vezril/EtherCoffee/flowcharts/eth0 init diagram.png

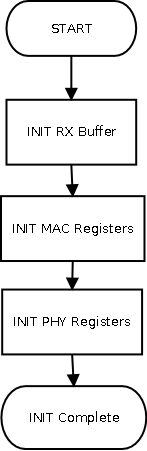
flowcharts/eth0 init diagram.png
