vezril/EtherCoffee/flowcharts/Exports/8088 - Init.png

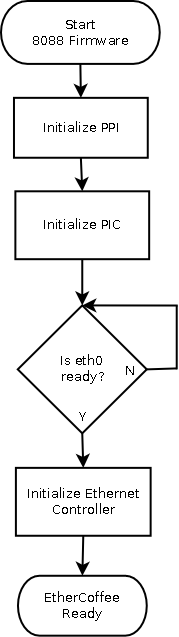
flowcharts/Exports/8088 - Init.png
