vezril/EtherCoffee/flowcharts/Exports/8088 - Poll.png

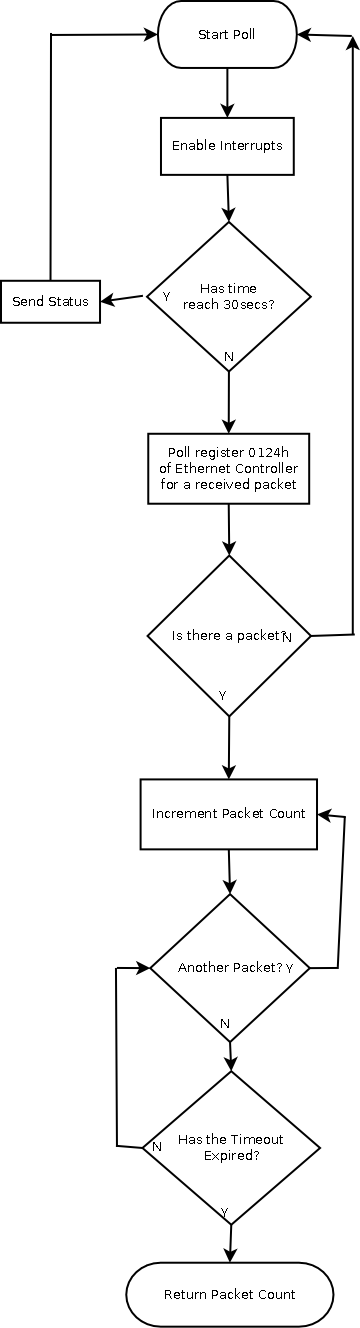
flowcharts/Exports/8088 - Poll.png
