vezril/EtherCoffee/flowcharts/Exports/8088 - Process Packets.png

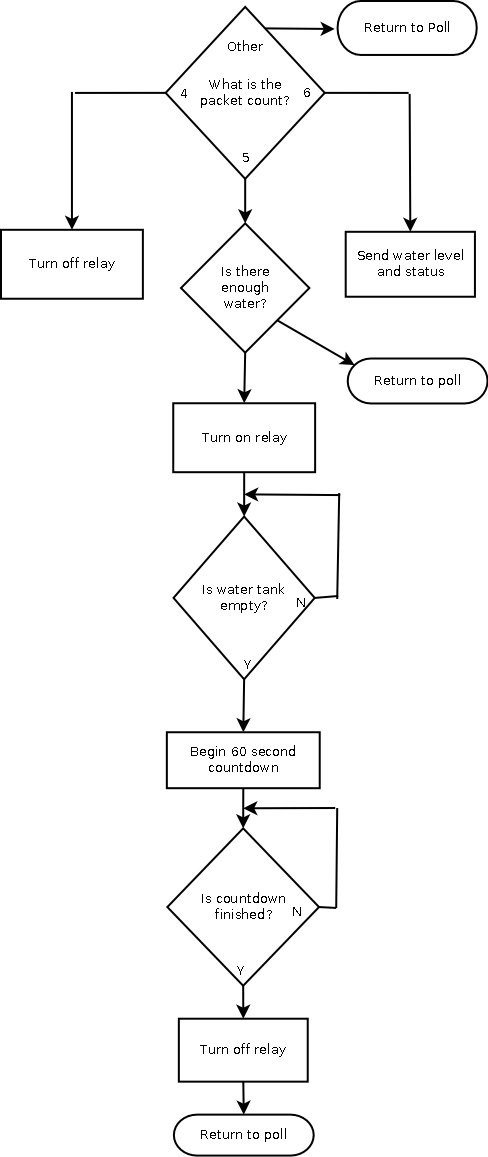
flowcharts/Exports/8088 - Process Packets.png
