vezril/EtherCoffee/flowcharts/Exports/8088 - recv.png

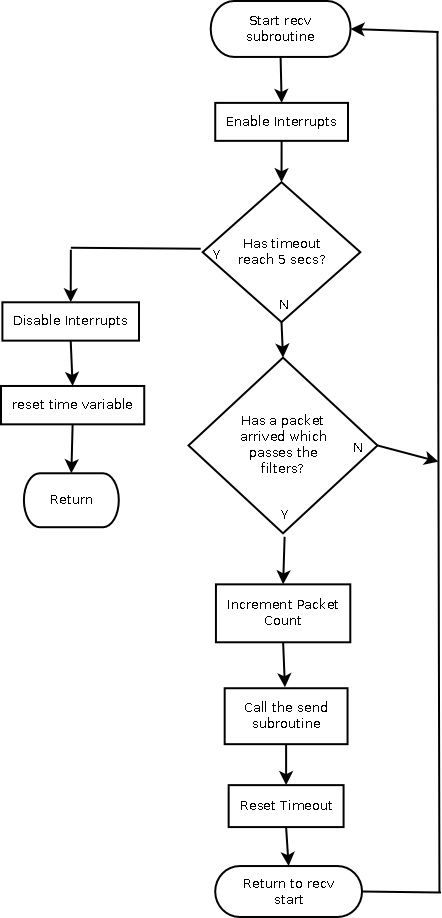
flowcharts/Exports/8088 - recv.png
