vezril/EtherCoffee/flowcharts/Exports/8088 - RTC.png

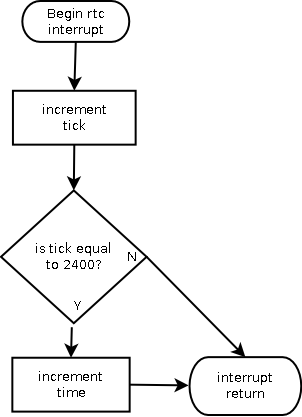
flowcharts/Exports/8088 - RTC.png
