vezril/EtherCoffee/flowcharts/Exports/ethercoffee - main.png

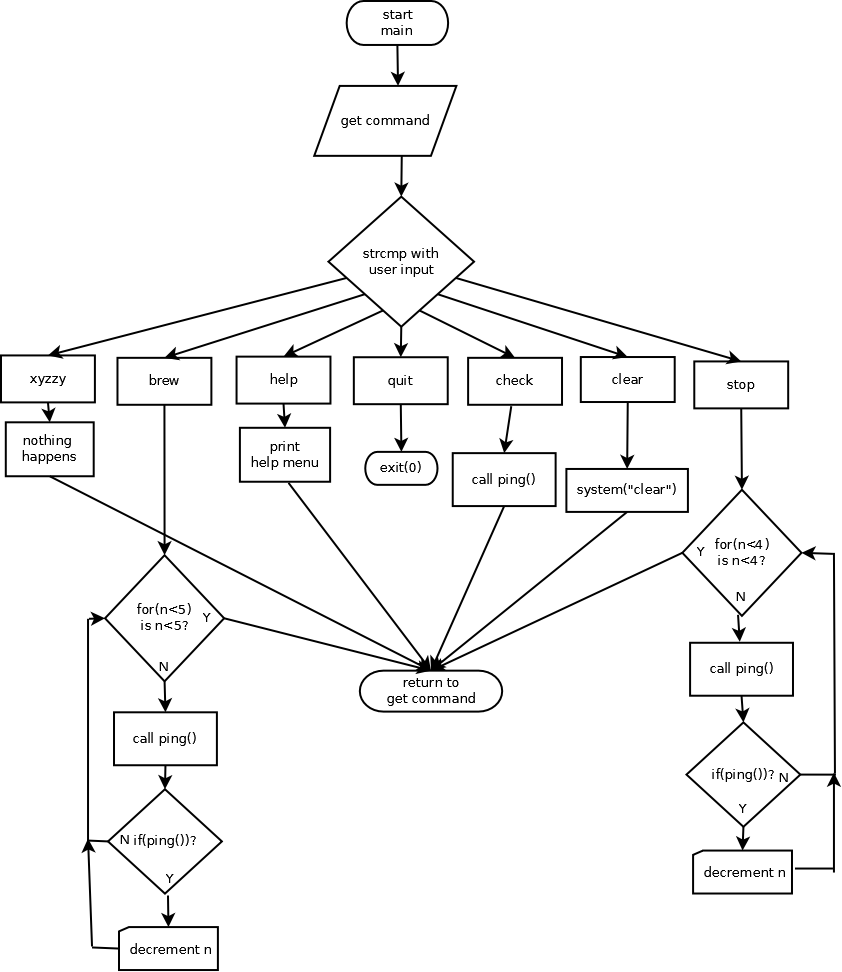
flowcharts/Exports/ethercoffee - main.png
