vezril/EtherCoffee/flowcharts/Exports/ethercoffee - ping.png

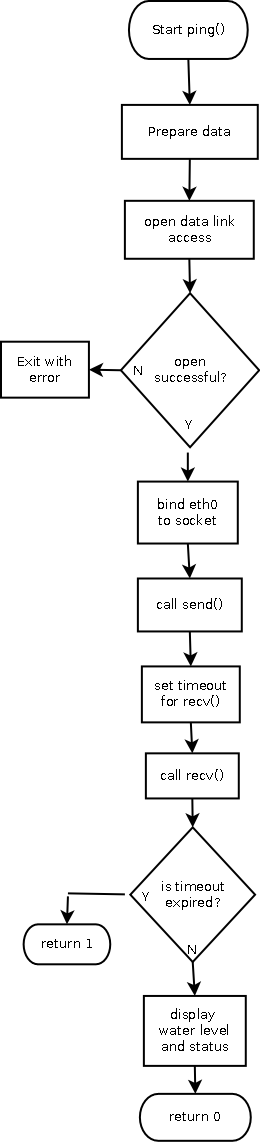
flowcharts/Exports/ethercoffee - ping.png
