vezril/EtherCoffee/flowcharts/Exports/ethercoffee - send.png

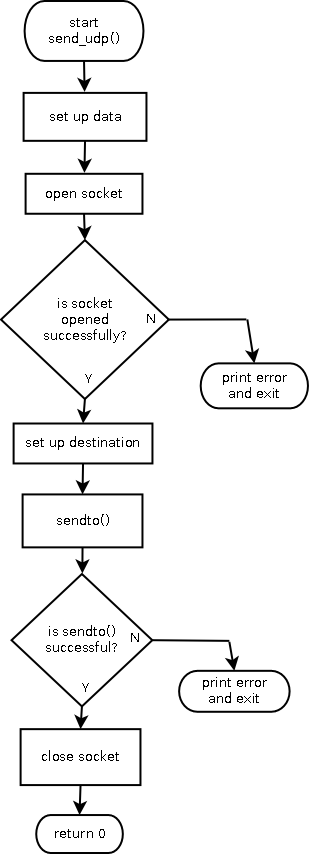
flowcharts/Exports/ethercoffee - send.png
