vezril/EtherCoffee/flowcharts/Exports/GUI - Brew.png

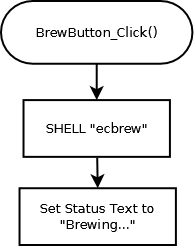
flowcharts/Exports/GUI - Brew.png
