vezril/EtherCoffee/flowcharts/Exports/GUI - Form_Open.png

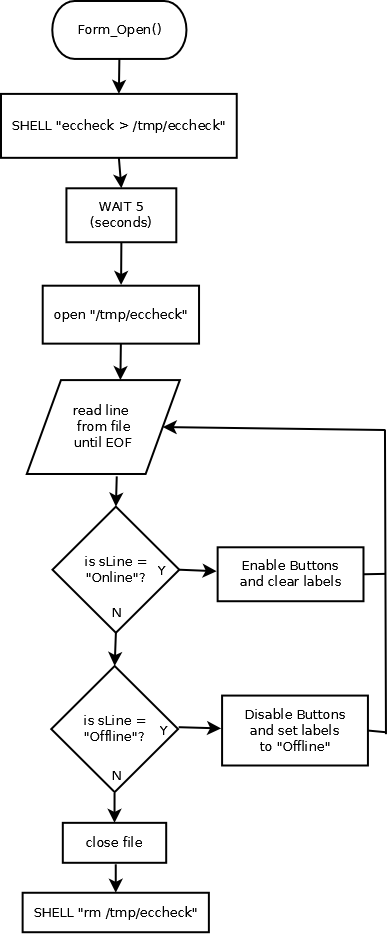
flowcharts/Exports/GUI - Form_Open.png
