vezril/EtherCoffee/flowcharts/Exports/GUI - Status.png

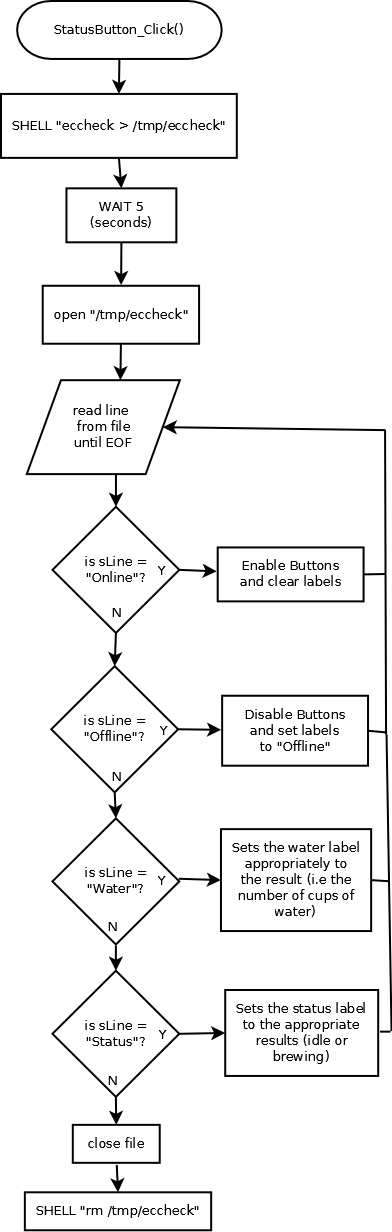
flowcharts/Exports/GUI - Status.png
