vezril/EtherCoffee/pcb/Switch/pcb_layout.jpg

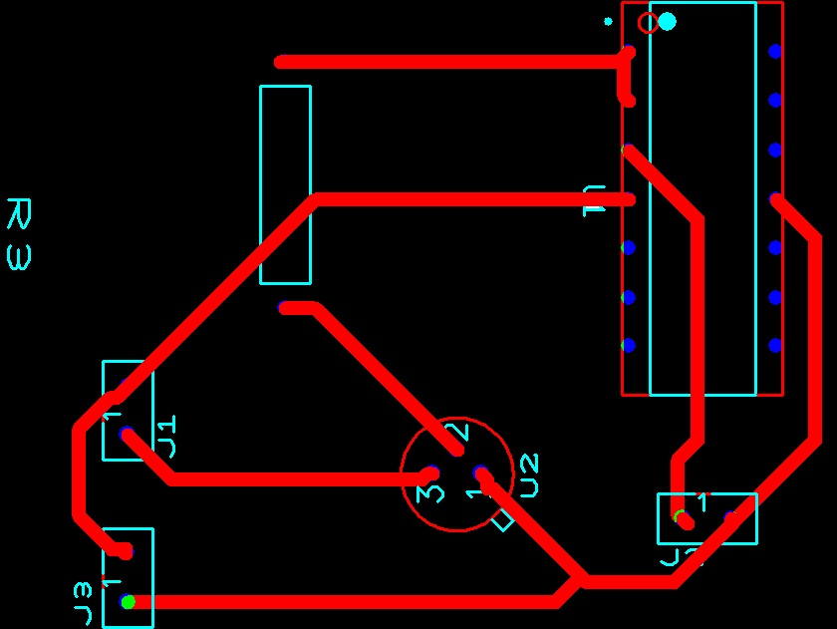
pcb/Switch/pcb_layout.jpg
