vezril/EtherCoffee/pictures/brew.png

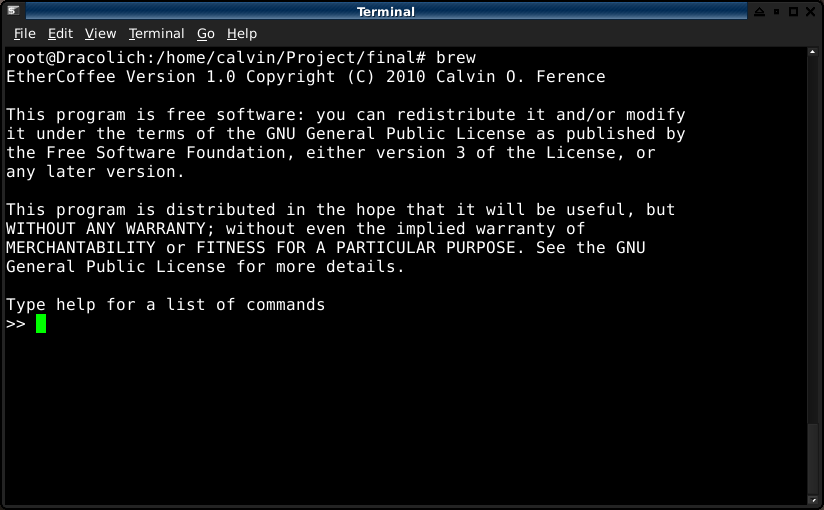
pictures/brew.png
