vezril/EtherCoffee/pictures/Cali - 1.jpg

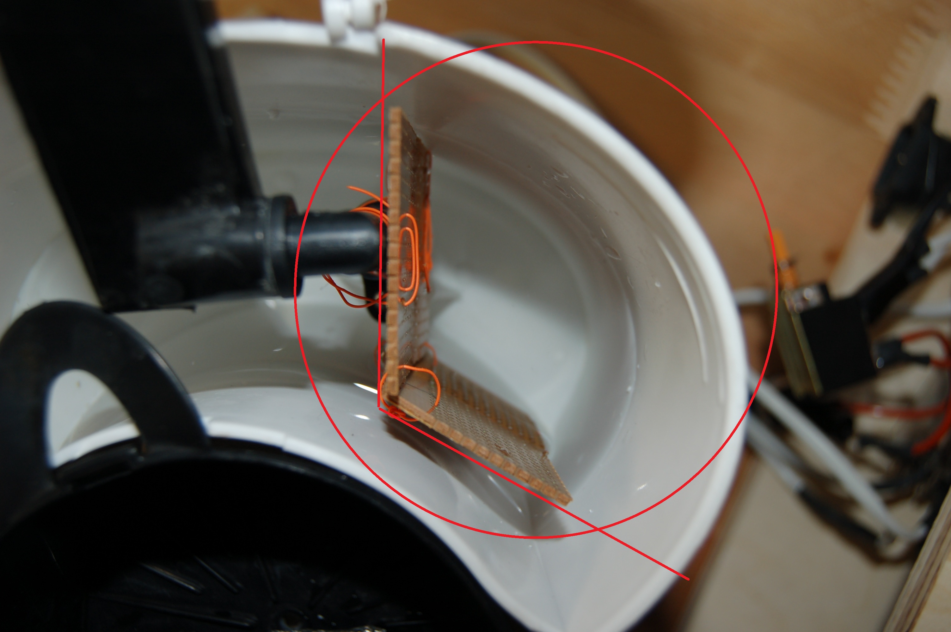
pictures/Cali - 1.jpg
