vezril/EtherCoffee/pictures/Cali - 2.jpg

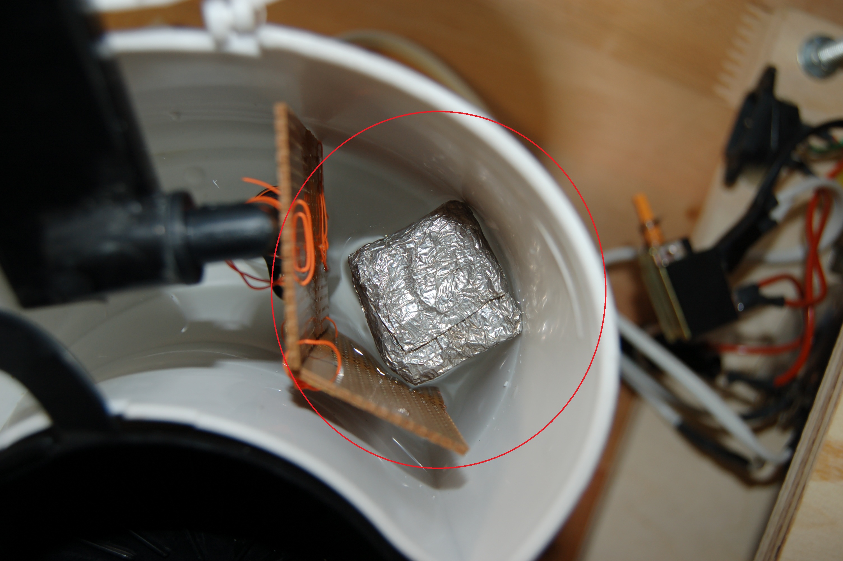
pictures/Cali - 2.jpg
