vezril/EtherCoffee/pictures/cartoon_fire.gif

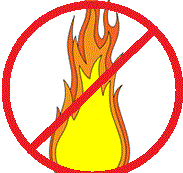
pictures/cartoon_fire.gif
