vezril/EtherCoffee/pictures/DigiCam/DSC_0043.JPG

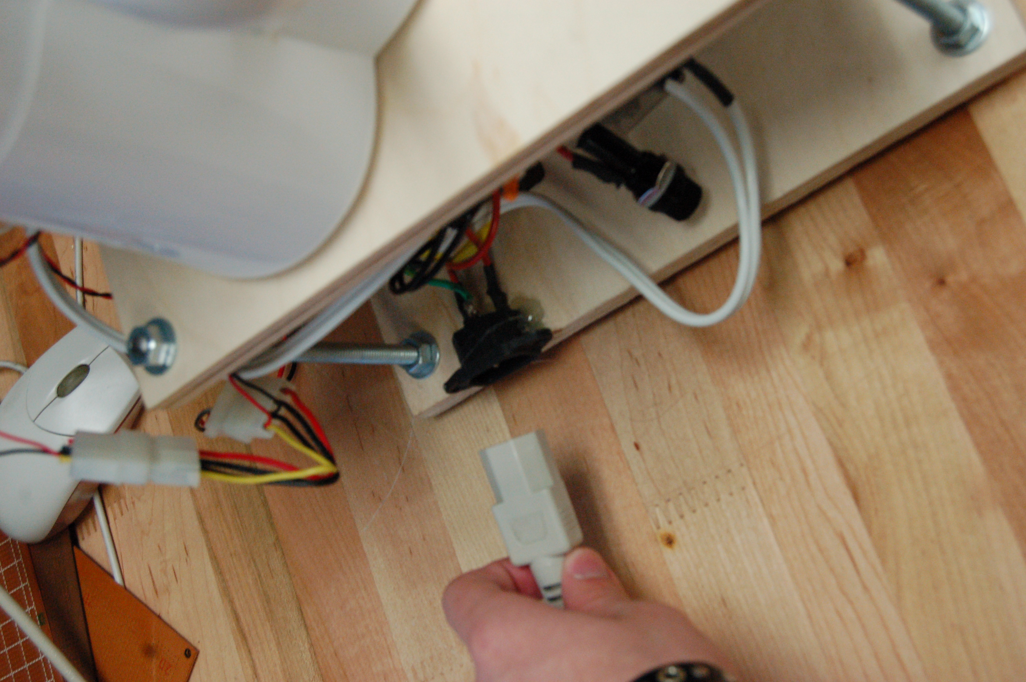
pictures/DigiCam/DSC_0043.JPG
