vezril/EtherCoffee/pictures/DigiCam/DSC_0044.JPG

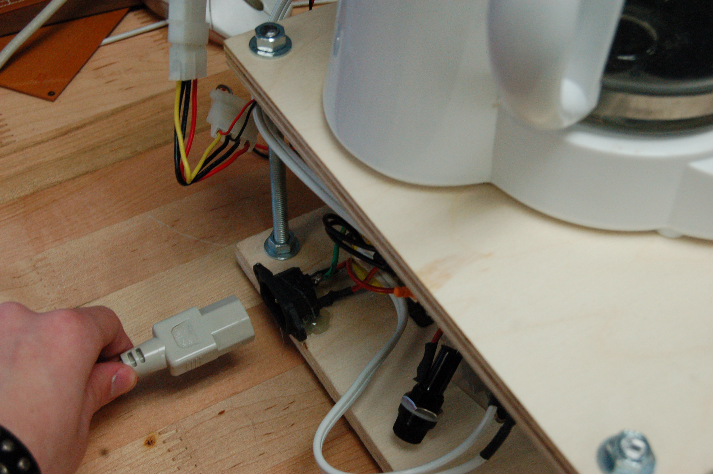
pictures/DigiCam/DSC_0044.JPG
