vezril/EtherCoffee/pictures/DigiCam/DSC_0045.JPG

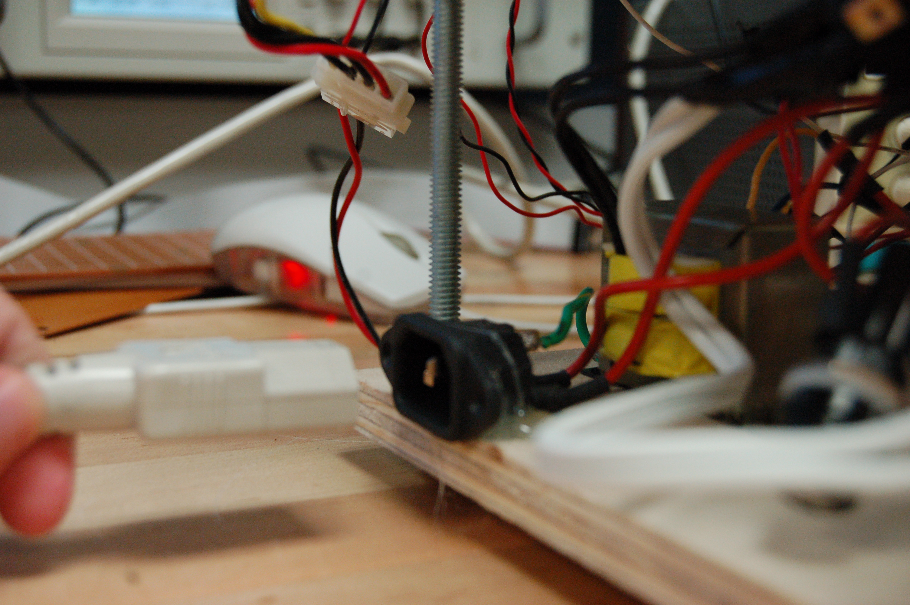
pictures/DigiCam/DSC_0045.JPG
