vezril/EtherCoffee/pictures/DigiCam/DSC_0047.JPG

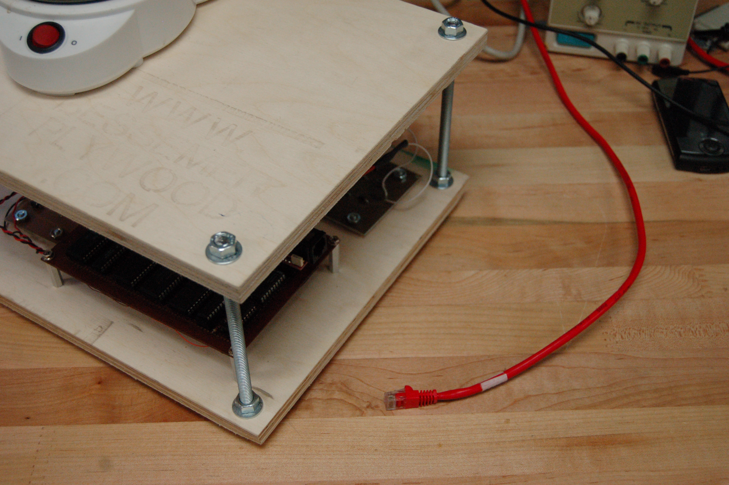
pictures/DigiCam/DSC_0047.JPG
