vezril/EtherCoffee/pictures/DigiCam/DSC_0048.JPG

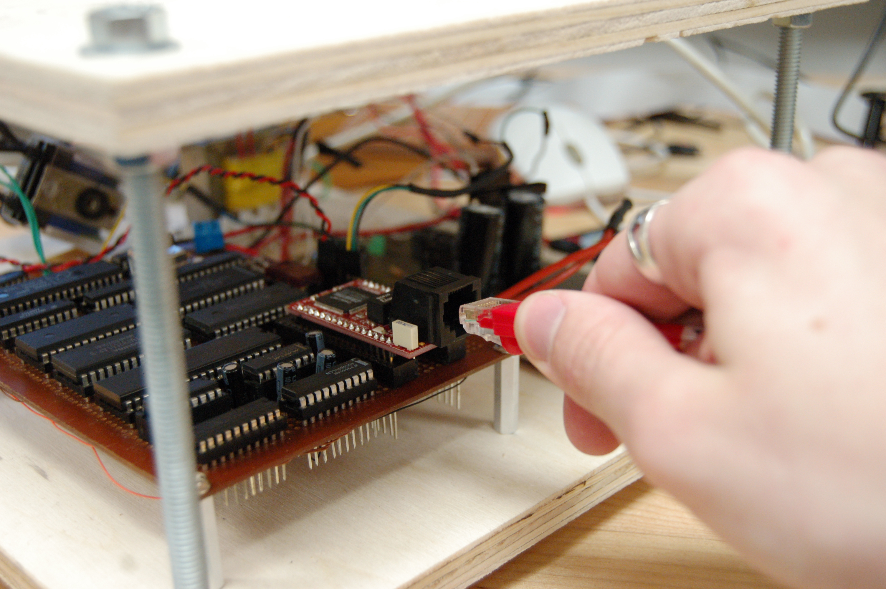
pictures/DigiCam/DSC_0048.JPG
