vezril/EtherCoffee/pictures/DigiCam/DSC_0049.JPG

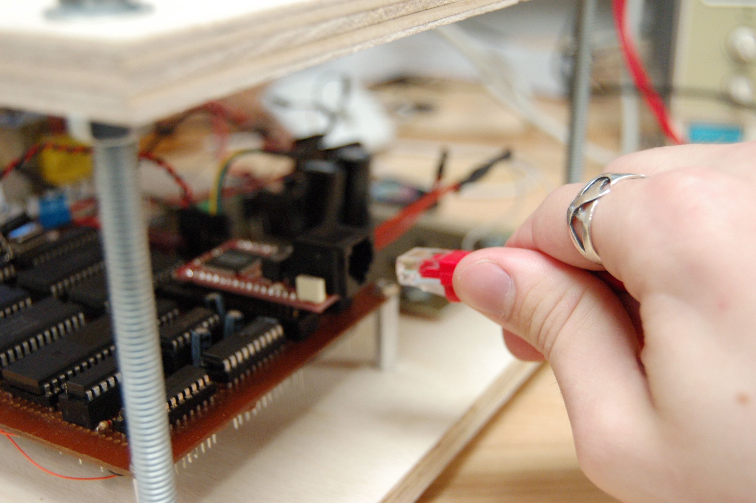
pictures/DigiCam/DSC_0049.JPG
