vezril/EtherCoffee/pictures/DigiCam/DSC_0050.JPG

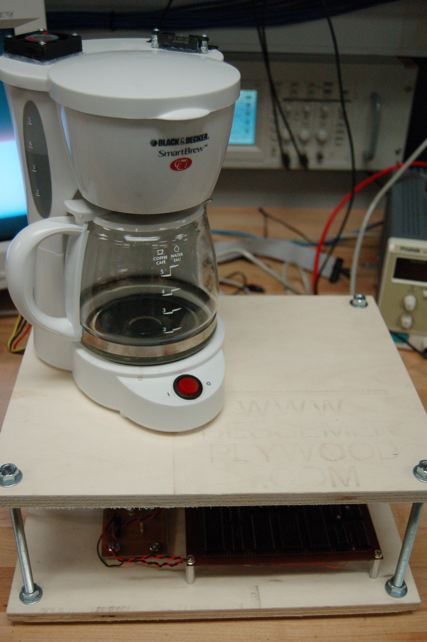
pictures/DigiCam/DSC_0050.JPG
