vezril/EtherCoffee/pictures/DigiCam/DSC_0051.JPG

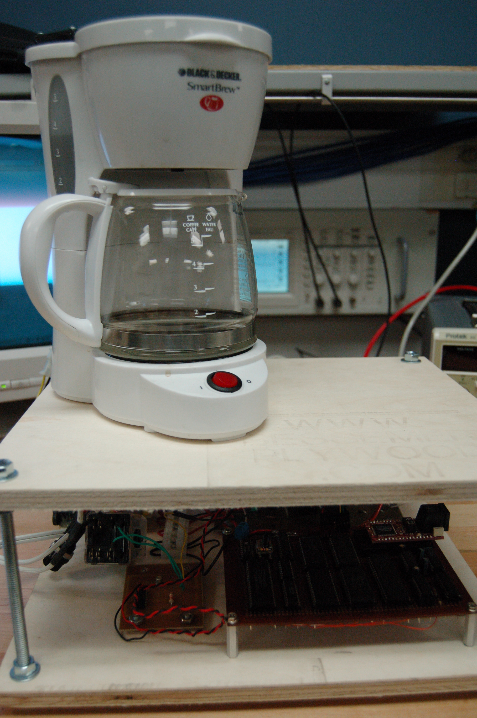
pictures/DigiCam/DSC_0051.JPG
