vezril/EtherCoffee/pictures/DigiCam/DSC_0053.JPG

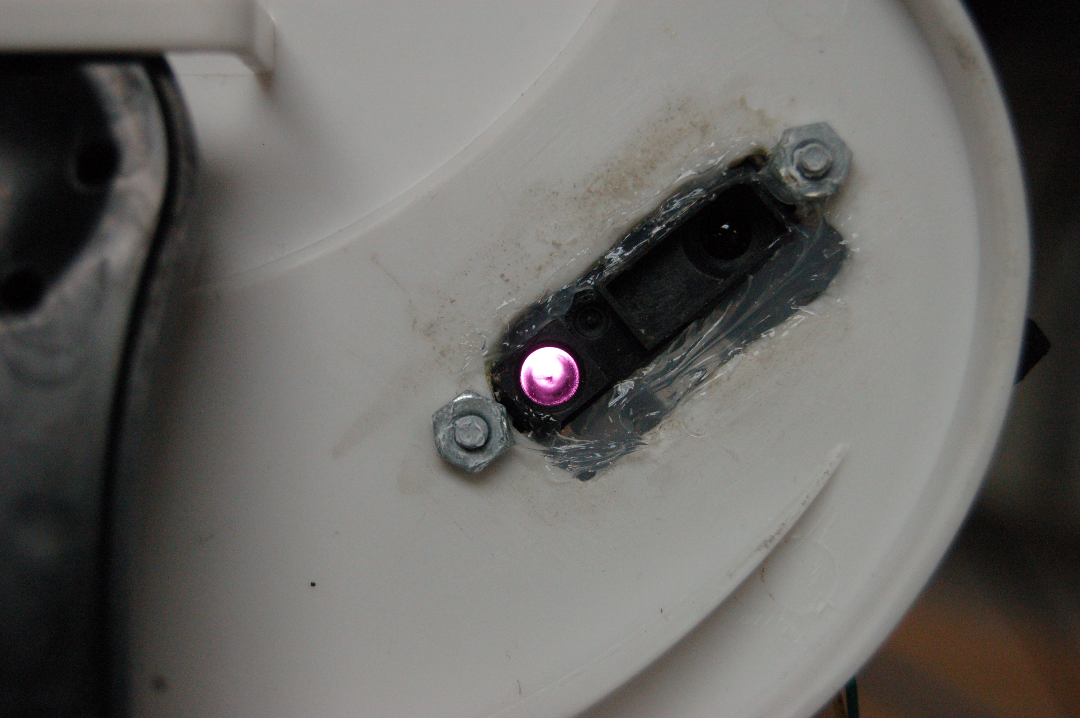
pictures/DigiCam/DSC_0053.JPG
