vezril/EtherCoffee/pictures/DigiCam/DSC_0059.JPG

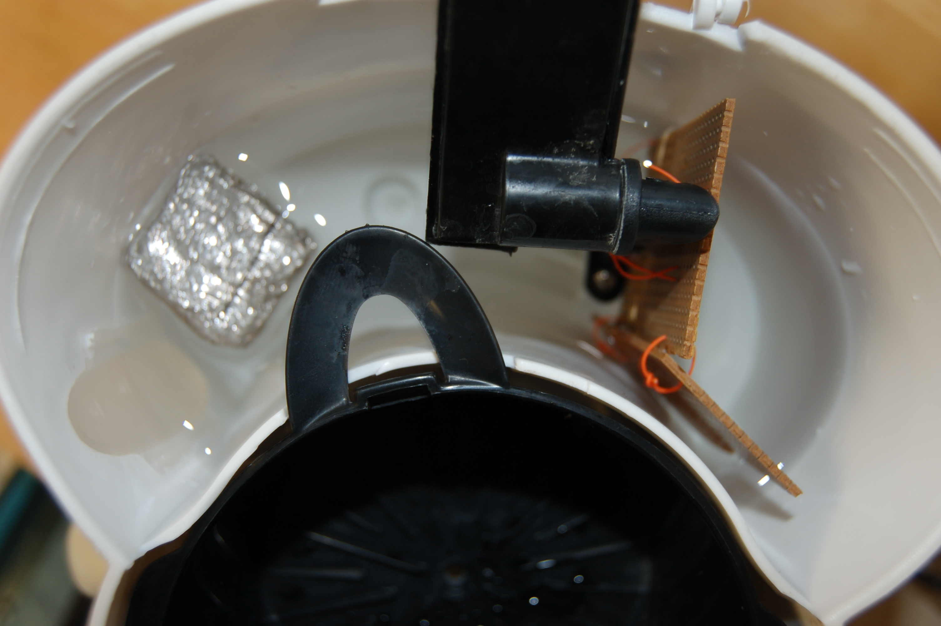
pictures/DigiCam/DSC_0059.JPG
