vezril/EtherCoffee/pictures/DigiCam/DSC_0060.JPG

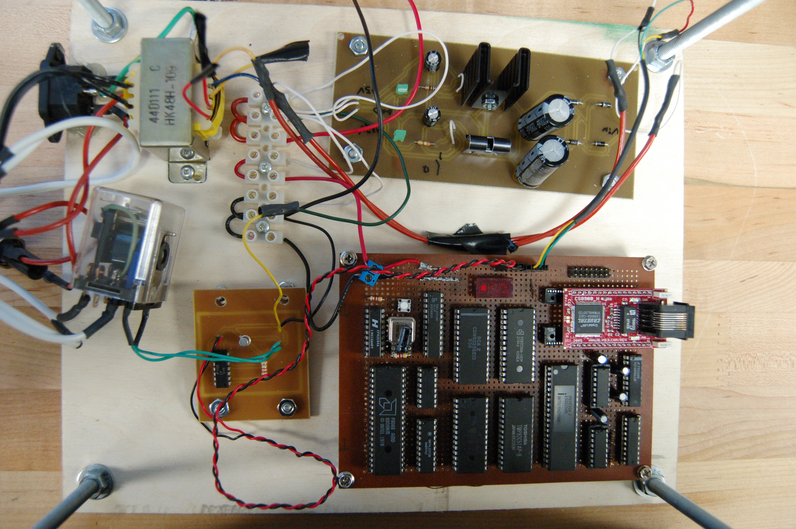
pictures/DigiCam/DSC_0060.JPG
