vezril/EtherCoffee/pictures/DigiCam/DSC_0061.JPG

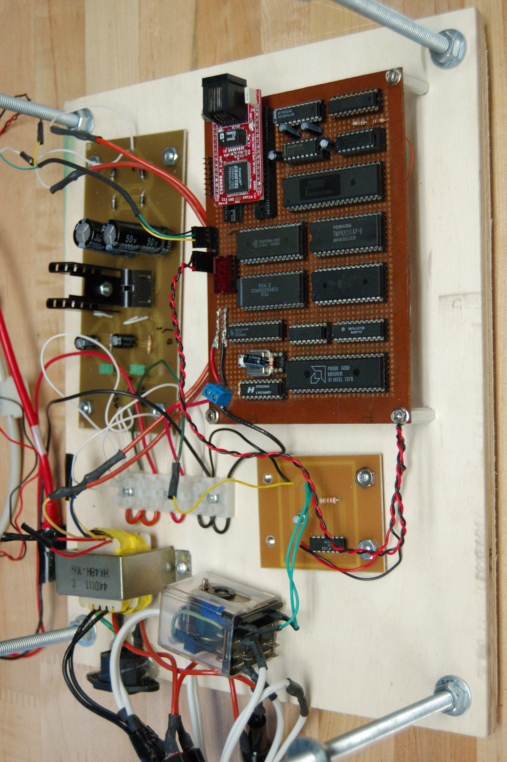
pictures/DigiCam/DSC_0061.JPG
