vezril/EtherCoffee/pictures/DigiCam/DSC_0145.JPG

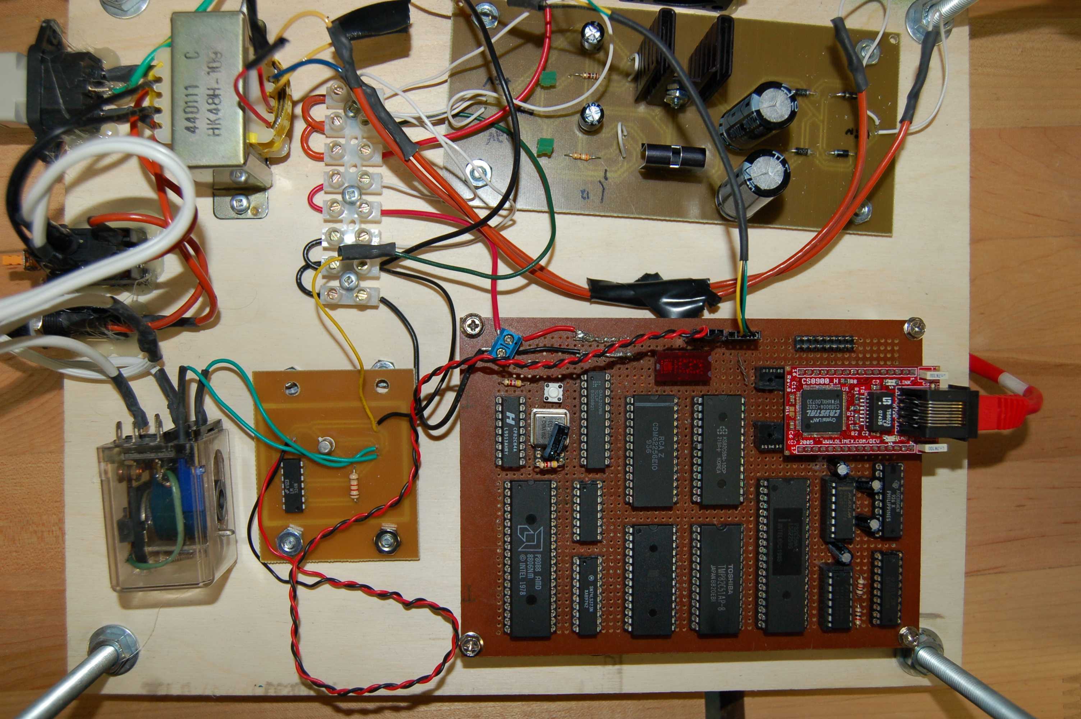
pictures/DigiCam/DSC_0145.JPG
