vezril/EtherCoffee/pictures/eccheck.png

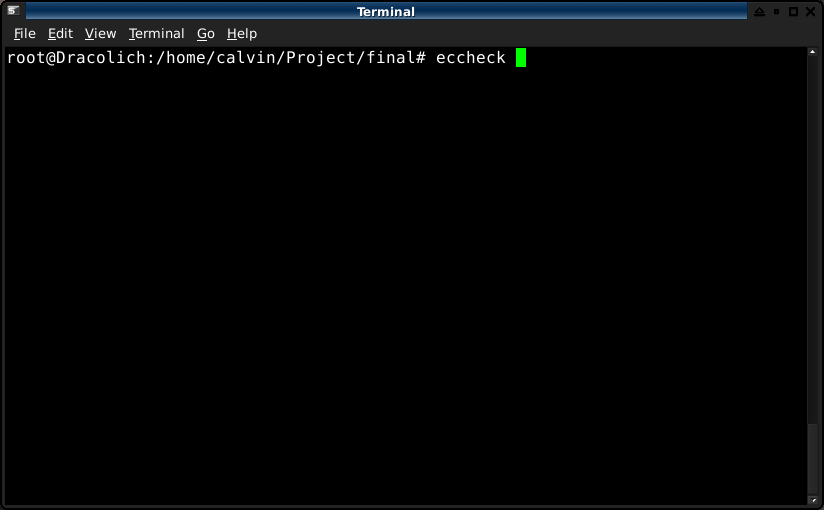
pictures/eccheck.png
