vezril/EtherCoffee/pictures/ethernet_frame_format.gif

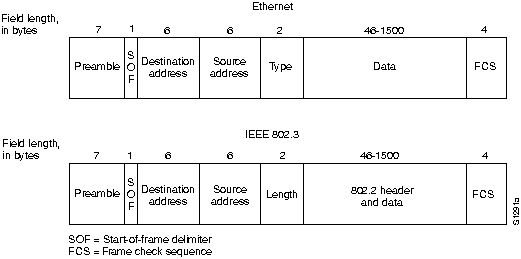
pictures/ethernet_frame_format.gif
