vezril/EtherCoffee/pictures/GUI.png

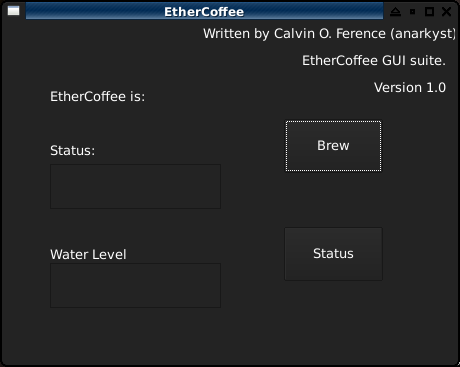
pictures/GUI.png
