vezril/EtherCoffee/pictures/water_drop.png

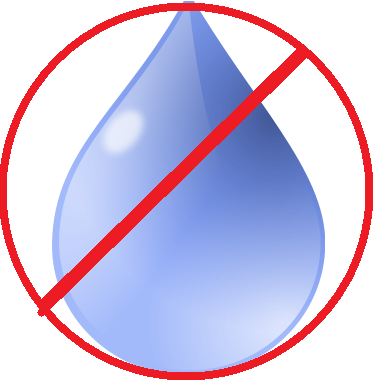
pictures/water_drop.png
