vezril/EtherCoffee/schematics/8088 - ADC.PNG

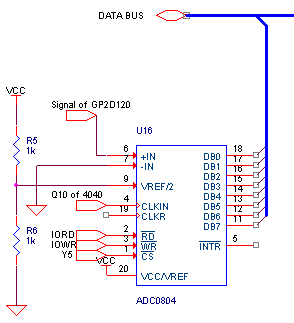
schematics/8088 - ADC.PNG
