vezril/EtherCoffee/schematics/8088 - PPI&PIC.PNG

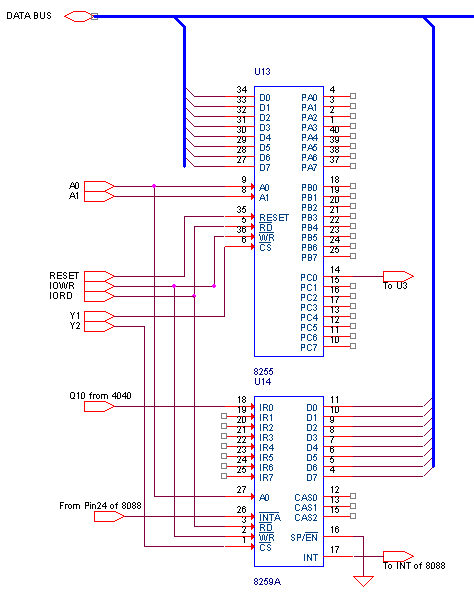
schematics/8088 - PPI&PIC.PNG
