vezril/EtherCoffee/schematics/8088 - UART.PNG

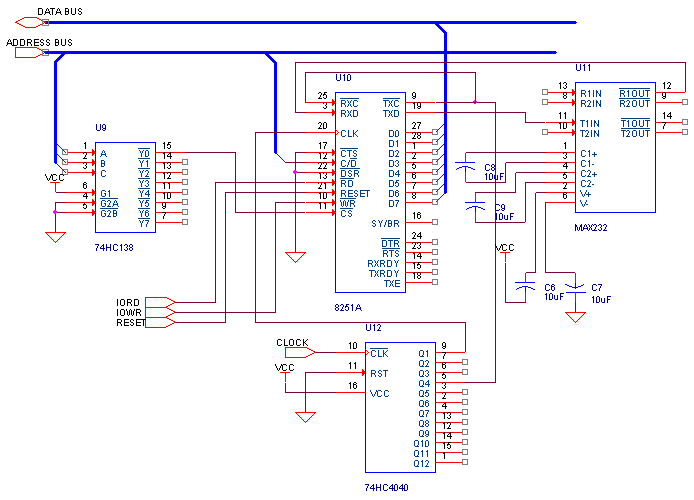
schematics/8088 - UART.PNG
