vezril/EtherCoffee/schematics/8088 - uP.PNG

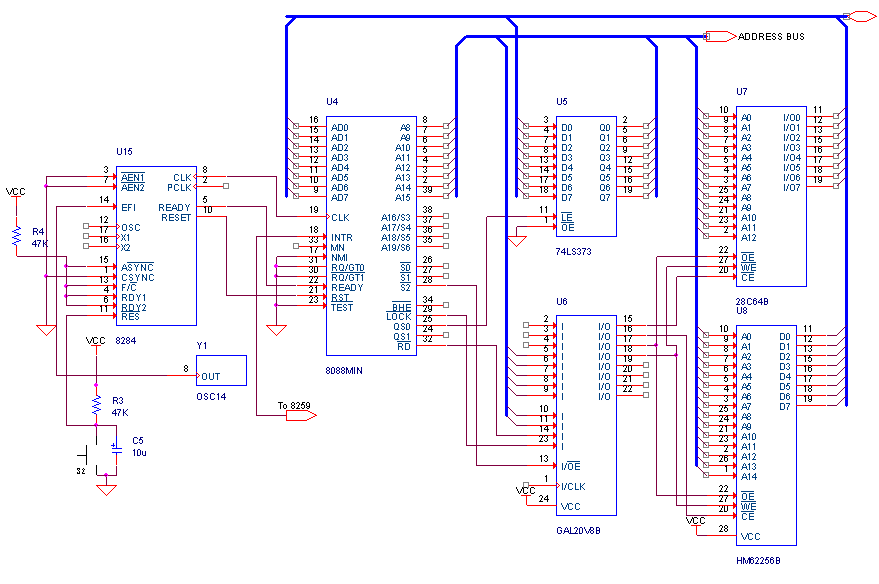
schematics/8088 - uP.PNG
