vezril/EtherCoffee/schematics/cs8900a-sch.gif

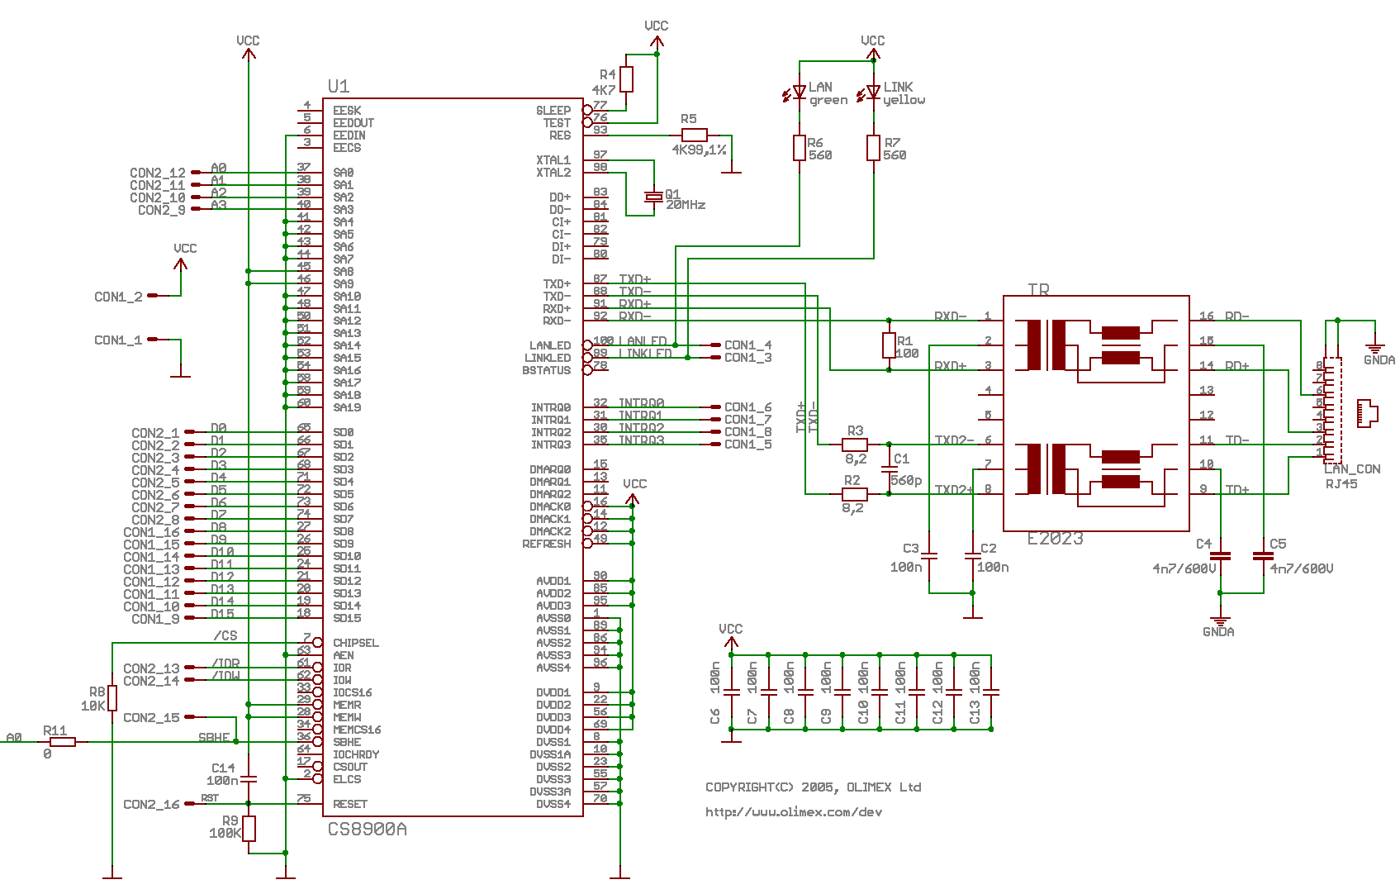
schematics/cs8900a-sch.gif
