vezril/EtherCoffee/BOM.ods

Bill of Materials
Part | Part Number | Quantity | Price | Total Price
Power Supply
100μF Capacitor | 100R50 | 2 | 0.21 | 0.42
2200μF Capacitor | 2200R50 | 2 | 0.74 | 1.48
Diodes | 1N4002 | 4 | 0.06 | 0.24
Heat Sink | HS-310 | 2 | 0.29 | 0.58
LED | Green | 2 | 0.10 | 0.20
Resistor | N/A | 2 | 0.04 | 0.08
Transformer | TRF-310 | 1 | 17.99 | 17.99
5V Voltage Regulator | 7805 | 1 | 0.42 | 0.42
12V Voltage Regulator | 7812 | 1 | 0.42 | 0.42
Switch
Resistor | N/A | 1 | 0.04 | 0.04
Relay | N/A | 1 | 4.99 | 4.99
Operation-Amplifier | LM324N | 1 | 0.35 | 0.35
Transistor | 2N2222 | 1 | 0.37 | 0.37
Micro Controller
12 Stage Binary Ripple | 74HC4040 | 1 | 0.71 | 0.71
3 to 8 Decoder | 74HC138 | 1 | 0.35 | 0.35
10μF Capacitors | 10R50V | 5 | 0.09 | 0.45
Analog to Digital Converter | ADC0804 | 1 | 3.49 | 3.49
Buffer | 74LS245 | 1 | 0.49 | 0.49
Crystal | 14.74MHz | 1 | 2.89 | 2.89
Dual Driver/Receiver | MAX232 | 1 | 2.49 | 2.49
Ethernet Controller | CS8900A-H | 1 | 41.95 | 41.95
GAL | GAL20V8B | 1 | 2.49 | 2.49
HEX Display | TIL311 | 1 | 12.99 | 12.99
IR Sensor | GP2D120 | 1 | 8.99 | 8.99
Latch | 74LS373 | 1 | 0.49 | 0.49
Microprocessor | 8088 | 1 | 2.89 | 2.89
Programmable Communication Interface | 8251 | 1 | 2.89 | 2.89
Programmable Interrupt Controller | 8259 | 1 | 2.79 | 2.79
Programmable Parallel Interface | 8255 | 1 | 2.99 | 2.99
Push-Button Switch | PBS-190 | 1 | 0.69 | 0.69
Random Access Memory | HM62256B | 1 | 6.99 | 6.99
Read Only Memory | AT28HC64B | 1 | 4.99 | 4.99
Resistors | N/A | 4 | 0.04 | 0.16
16-Pin Wire-wrap socket | MS16WW | 3 | 1.12 | 3.36
18-Pin Wire-wrap socket | MS18WW | 1 | 1.19 | 1.19
20-Pin Wire-wrap socket | MS20WW | 3 | 1.39 | 4.17
24-Pin Wire-wrap socket | MS24WW | 1 | 1.49 | 1.49
28-Pin Wire-wrap socket | MS28WW | 4 | 1.72 | 6.88
40-Pin Wire-wrap socket | MS41WW | 3 | 2.69 | 8.07
Miscellaneous
Cable | N/A | 1 | 19.99 | 19.99
Coffee Machine | DCM500 | 1 | 19.99 | 19.99
Fans | N/A | 2 | 2.99 | 5.98
Fuse | 15A | 1 | 1.99 | 1.99
Fuse Holder | FH110 | 1 | 0.89 | 0.89
DPST Switch | AT Power-Supply | 1 | 2.83 | 2.83
Metal Rods | N/A | 1 | 2.99 | 2.99
Nuts and Bolts | N/A | 48 | 0.09 | 4.32
Terminal Block | N/A | 1 | 4.99 | 4.99
Vector Boards | N/A | 2 | 2.49 | 4.98
Wood | N/A | 1 | 11.99 | 11.99
Total |  |  |  | 235.85
