vezril/EtherCoffee/Parts List.ods

Appendix C – Parts List
Power Supply Unit
Designator | Part | Value
C1, C2 | Capacitor | 2200μF
C3, C4 | Capacitor | 100μF
D1, D2, D3, D4 | Diode | 1N4002
D5, D6 | LED | Green
F1 | Fuse | 15A250V
J1 | Terminal Block | 8 Terminal
R1 | Resistor | 180Ω
R2 | Resistor | 390Ω
S1 | Power Switch | N/A
T1 | Transformer | N/A
U1 | Voltage Regulator | 7805
U2 | Voltage Regulator | 7812
Switch
K1 | Relay | 15 Amp 120 VAC
Q1 | Transistor | 2N2222
R3 | Resistor | 1.2kΩ
U3 | Operation Amplifier | LM324
Intel 8088 Minimal System
C5, C6, C7, C8, C9 | Capacitor | 10μF
R3, R4 | Resistor | 47kΩ
R5, R6 | Resistor | 1kΩ
S2 | Push-Button Switch | N/A
U4 | Microprocessor | Intel 8088
U5 | Latch | 74LS373
U6 | GAL | G20V8
U7 | ROM | Atmel 28C64B
U8 | RAM | HM62256B
U9 | 3 to 8 Decoder | 74HC138
U10 | UART | 8251
U11 | Dual Driver/Receiver | MAX232
U12 | 12 Stage Binary ripple counter | 74HC4040
U13 | Programmable Peripheral Interface | 8255
U14 | Programmable Interrupt Controller | 8259
U15 | Supply and Control Voltage Regulator | 8284
U16 | Ethernet Controller | CS8900A-H
U17 | Buffer | 74HC245
U18 | Analog to Digital Converter | ADC0804
Y1 | Crystal | 14.9MHz
