vezril/EtherCoffee/pcb/Ethernet PICtail Rev 5 BOM.xls

02-01841 Rev 5 |  |  |  | Pic Kit Ethernet
Note: Use Vendor part number for reference, a few Digikey part numbers may be the lead version
Count | ComponentName | RefDes | Value | Description | Vendor | Vendor # | Digikey # | RoHS
1 | BRRECT-W02M | CR1 |  | RECTIFIER BRIDGE 1.5A 200V WOG | General Semiconductor | W02G-E4 | W02GGI-ND | TRUE
1 |  | U1 | 25C256 | EEPROM | Microchip | 25LC256-I/SN |  | TRUE
1 |  | U3 | ENC28J60 | Ethernet IC | Microchip | ENC28J60-I/ML |  | TRUE
1 | MC74VHCT125A-D | U2 |  | IC QUAD BUFF HS TRI-ST 14-SOIC | On Semiconductor | MC74VHCT125A-D | Newark 75C3053 | TRUE
1 | MC78XX_DPAC | Q2 |  | IC REGULATOR LDO 1A TO-263 | National Semiconductor | LM2940S-5.0/NOPB | LM2940S-5.0-ND | TRUE
0 | MC78XX_DPAC | Q1 | No Load | IC REGULATOR LDO TO-263 | National Semiconductor | LM3940IS-3.3 | LM3940IS-3.3-ND | N/A
1 | MC78XX_DPAC | Q1 |  | 500mA Fixed Output CMOS LDO | Microchip | TC1262-3.3VEB |  | ?
12 | CAP0603 | C1, C2, C3, C4, C6, C7, C8, C9, C11, C13, C14, C18 | .1uF | CAP SMT, 0.1uF 0603 CER 16V 10% X7R | NIC COMPONENTS CORP | NMC0603X7R104K16TRPF |  | TRUE
2 | CAP0603 | C5, C17 | 33pf | CAP CER 33PF 50V C0G 5% 0603 | TDK Corporation | C1608C0G1H330J | 445-1275-1-ND | TRUE
1 | CAP0805 | C12 | 10uF | CAP CER 10UF 6.3V Y5V 0805 | Murata | GRM21BF50J106ZE01L | 490-1746-1-ND | TRUE
2 | CAP B | C15, C16 | 33uF | CAP 33UF 10V ELECT VS SMD | Panasonic - ECG | EEE1AA330WR | PCE3175CT-ND | TRUE
1 | CAP_SMT_F | C10 | 220uF | CAP 220UF 25V ELECT VS SMD | Panasonic - ECG | EEE1EA221UP | PCE3187TR-ND | TRUE
1 | CRYSTAL_CS10 | Y1 | 25Mhz | CRYSTAL 25.0000 MHZ 18PF SMD | CITIZEN | CS10-25.000MABJTR | 300-8105-1-ND | TRUE
4 | RES0603 | R3, R4, R5, R6 | 49.9, 1% | RES 49.9 OHM 1/16W 1% 0603 SMD | Rohm | MCR03EZPFX49R9 | RHM49.9HCT-ND | TRUE
6 | RES0603 | R2, R7, R9, R10, R11, R12 | 180 | RES 180 OHM 1/10W 5% 0603 SMD | Rohm | MCR03EZPJ181 | RHM180GCT-ND | TRUE
1 | RES0603 | R8 | 2.7K, 1% | RES 2.70K OHM 1/10W 1% 0603 SMD | Rohm | MCR03EZPFX2701 | RHM2.70KHCT-ND | TRUE
1 | RES0603 | R1 | 100K | RES SMT, 100K-OHM 1/16W 5% 0603 | KOA | RK73B1JTTD104J |  | TRUE
1 | DJ005B | J11 |  | CONN, JACK, 2.5mm DC PC MOUNT | KYCON | KLD-0202-B |  | TRUE
1 | INDUCTOR-1210 | L1 | 60ohm | FERRITE 1.5A 60 OHM 1210 SMD | Steward | MI1210K600R-10 | 240-2416-1-ND | TRUE
1 | LED-0805 | D1 | GREEN | LED THIN 565NM GRN DIFF 0805 SMD | Lumex Opto | SML-LXT0805GW-TR | 67-1553-1-ND | TRUE
1 |  | J1 |  | Mag Jack | Bel Stewart | 08B0-1X1T-36-F |  | TRUE
0 | Alternate | J1 |  | Pulse Jack | Pulse Engineering | JP011821UNL |  | TRUE
1 |  | J2 |  | CONN HEADER .100 DUAL R/A 28POS | SAMTEC | TSW-114-08-G-D-RA |  | TRUE
1 |  | J3 |  | 2x14 header female | SAMTEC | SSW-114-01-T-D |  | TRUE
1 |  | None |  | 2x14 header female (ship loose in box) |  |  |  | TRUE
0 |  | J8, JP1, JP2, JP3 | No Load |  |  |  |  | N/A
0 |  | J4, J5, J6, J7 | No Load |  |  |  |  | N/A
1 |  | J9 |  | 1x3 header | SAMTEC | TSW-103-07-S-S |  | TRUE
1 | Load @ | J9 (pins 2&3) |  | 2 pin shorting jumper | AMP/TYCO | 382811-6 | A26227-ND | TRUE
0 |  | J10 | No Load | 2x6 header |  |  |  | N/A
1 |  | TP2 |  | TEST POINT, BLACK (0.063" HOLE) | COMPONENTS CORP | TP-106-01-00 |  | TRUE
2 |  | TP1, TP3 |  | TEST POINT, RED (0.063" HOLE) | COMPONENTS CORP | TP-106-01-02 |  | TRUE
Changes from Rev 3
C3 | Change from .01uF to .1uF
C12 | Change from electrolitic to ceramic
R12 | Add 200 ohm (new value)
R9 | Change from 100K to 200 ohm
R11 | Change from NL to 200 ohm
JP1, JP2, JP3 | Add No Load
C19 | Delete
Y1 | Change to new part
L1 | Change to RoHS part (-10 suffix)
C5, C17 | Change to 33pf
R9, R10, R11, R12 | Change to 180 Ohm
