vezril/EtherCoffee/Header Pinout.ods

NOTE | Value | Pin | Pin | Value | NOTE | HDR_Pin | RJ45_Pin | Value
 | GND | 1 | 40 | GND |  | 1 | 6 | RCT
 | D7 | 2 | 39 | CS2 | Y4 | 2 | 5 | RD-
 | D6 | 3 | 38 | CS1 | Y5 | 3 | 4 | RD+
 | D5 | 4 | 37 | CS0 | Y6 | 4 | 10 | LED2_1
 | D4 | 5 | 36 | BLANK |  | 5 | 9 | LED2_2
 | D3 | 6 | 35 | BLANK |  | 6 | 3 | TD-
 | D2 | 7 | 34 | BLANK |  | 7 | 2 | TD+
 | D1 | 8 | 33 | BLANK |  | 8 | 8 | LED1_Neg
 | D0 | 9 | 32 | NC |  | 9 | 7 | LED1_Pos
 | GND | 10 | 31 | BLANK |  | 10 | 1 | TCT
 | A1 | 11 | 30 | A3
 | A0 | 12 | 29 | A2
 | GND | 13 | 28 | GND
 | BLANK | 14 | 27 | RESET
 | BLANK | 15 | 26 | /RD
 | BLANK | 16 | 25 | /WR
 | BLANK | 17 | 24 | BLANK
 | VCC | 18 | 23 | VCC
 | BLANK | 19 | 22 | BLANK
 | GND | 20 | 21 | GND
