vezril/EtherCoffee/(list of files, cad)

Other CAD files:
utils/MASM/m88io.obj
utils/MASM/tst.obj
utils/MASM/ppitst.obj
