vezril/EtherCoffee/pictures/Setup - 4.JPG

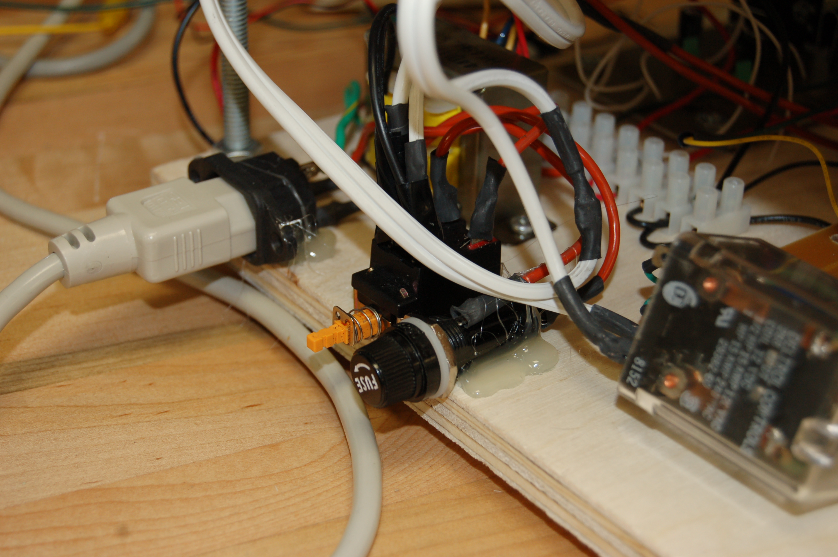
pictures/Setup - 4.JPG
