vezril/EtherCoffee/schematics/08B0-1X1T-36-F.pdf

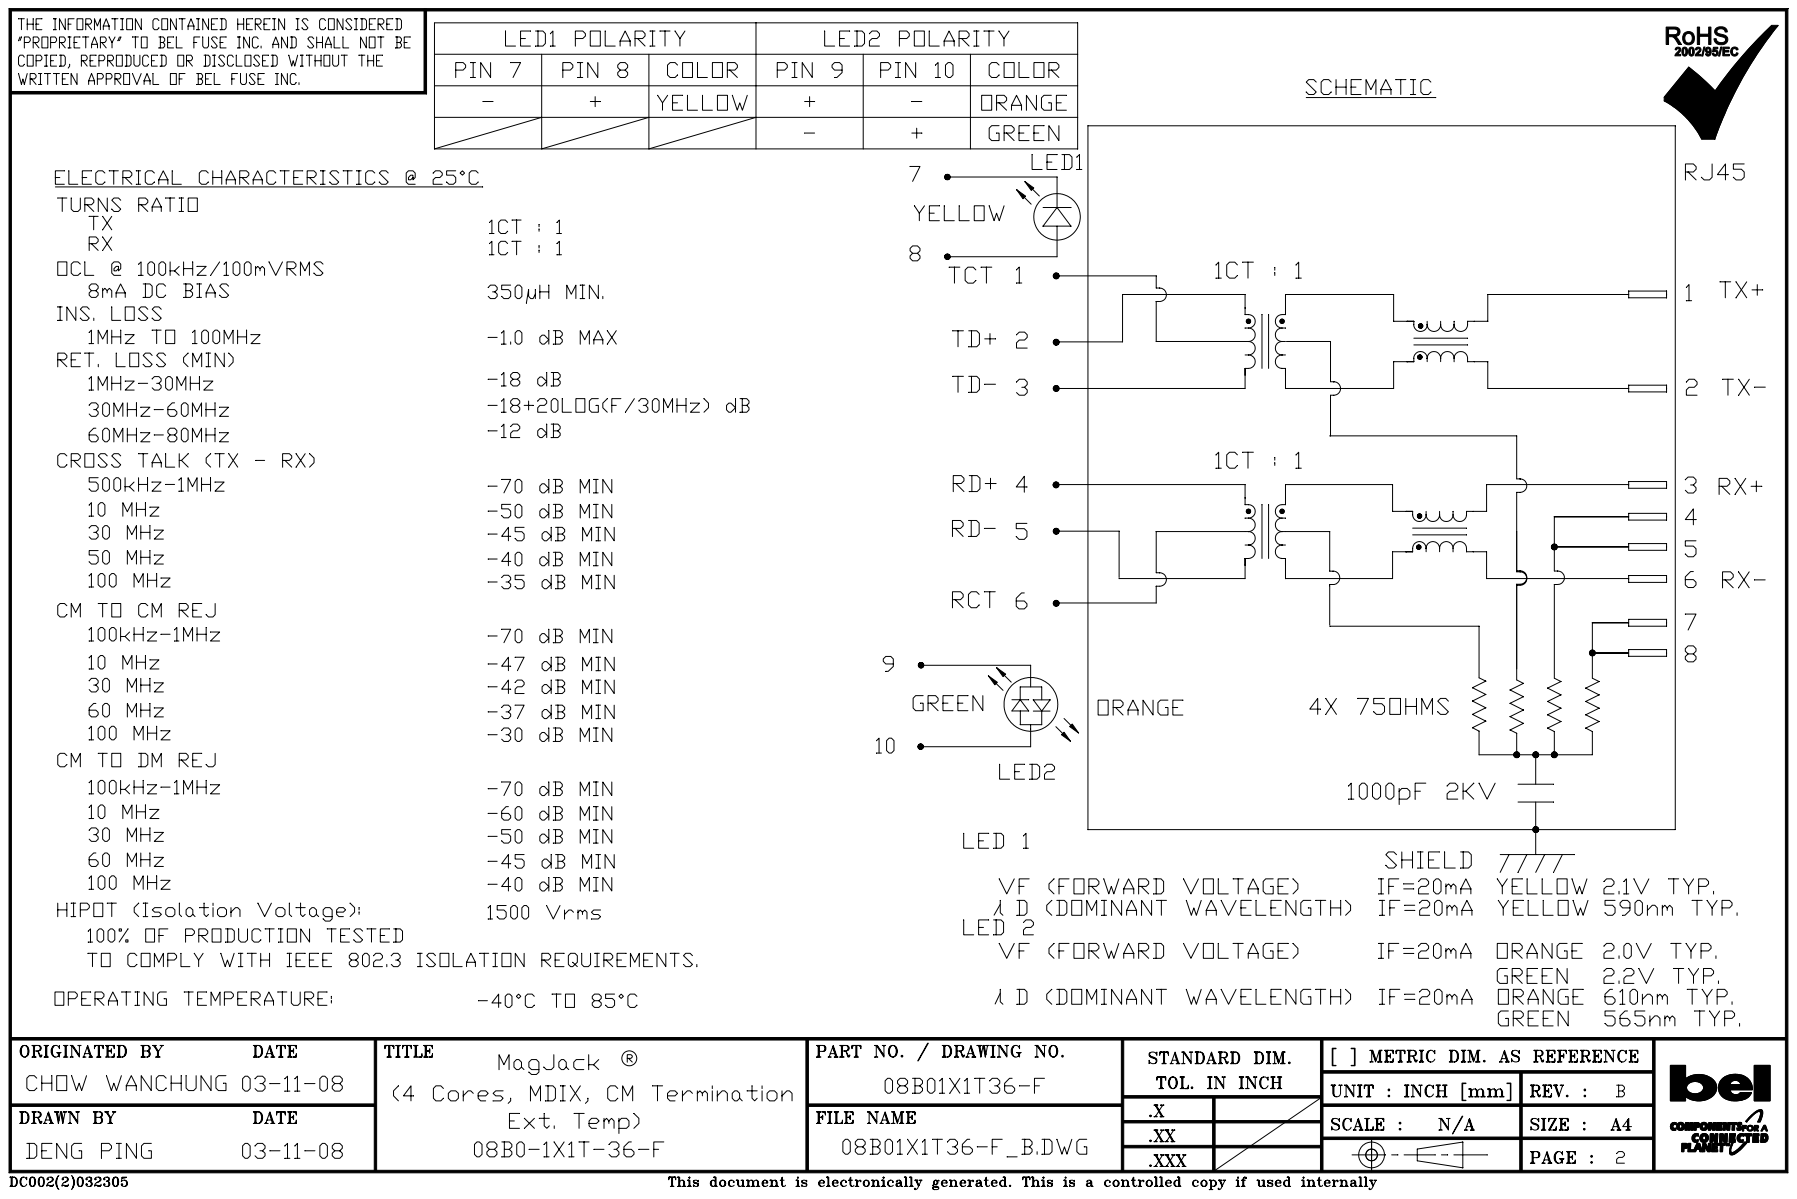
[picture p54: page 1]

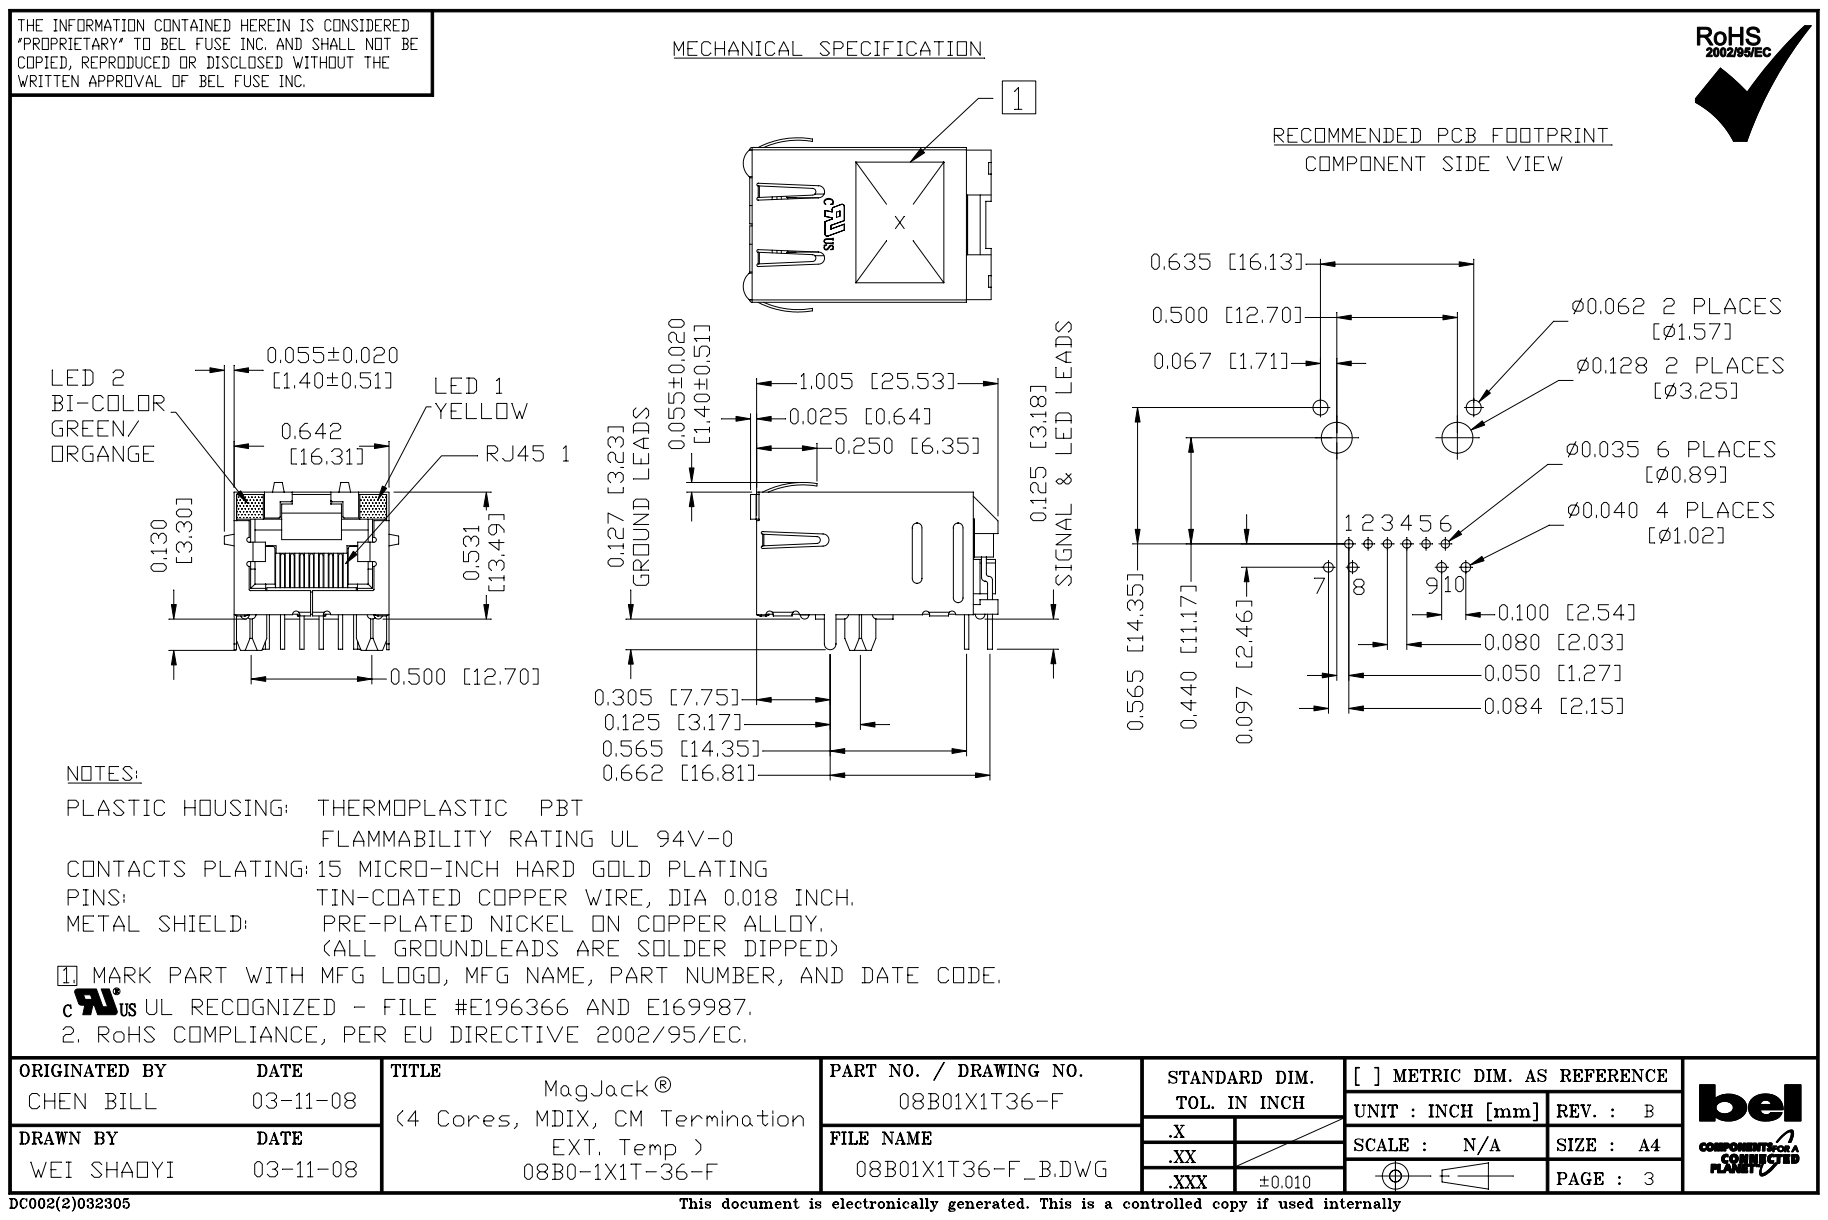
[picture p55: page 2]

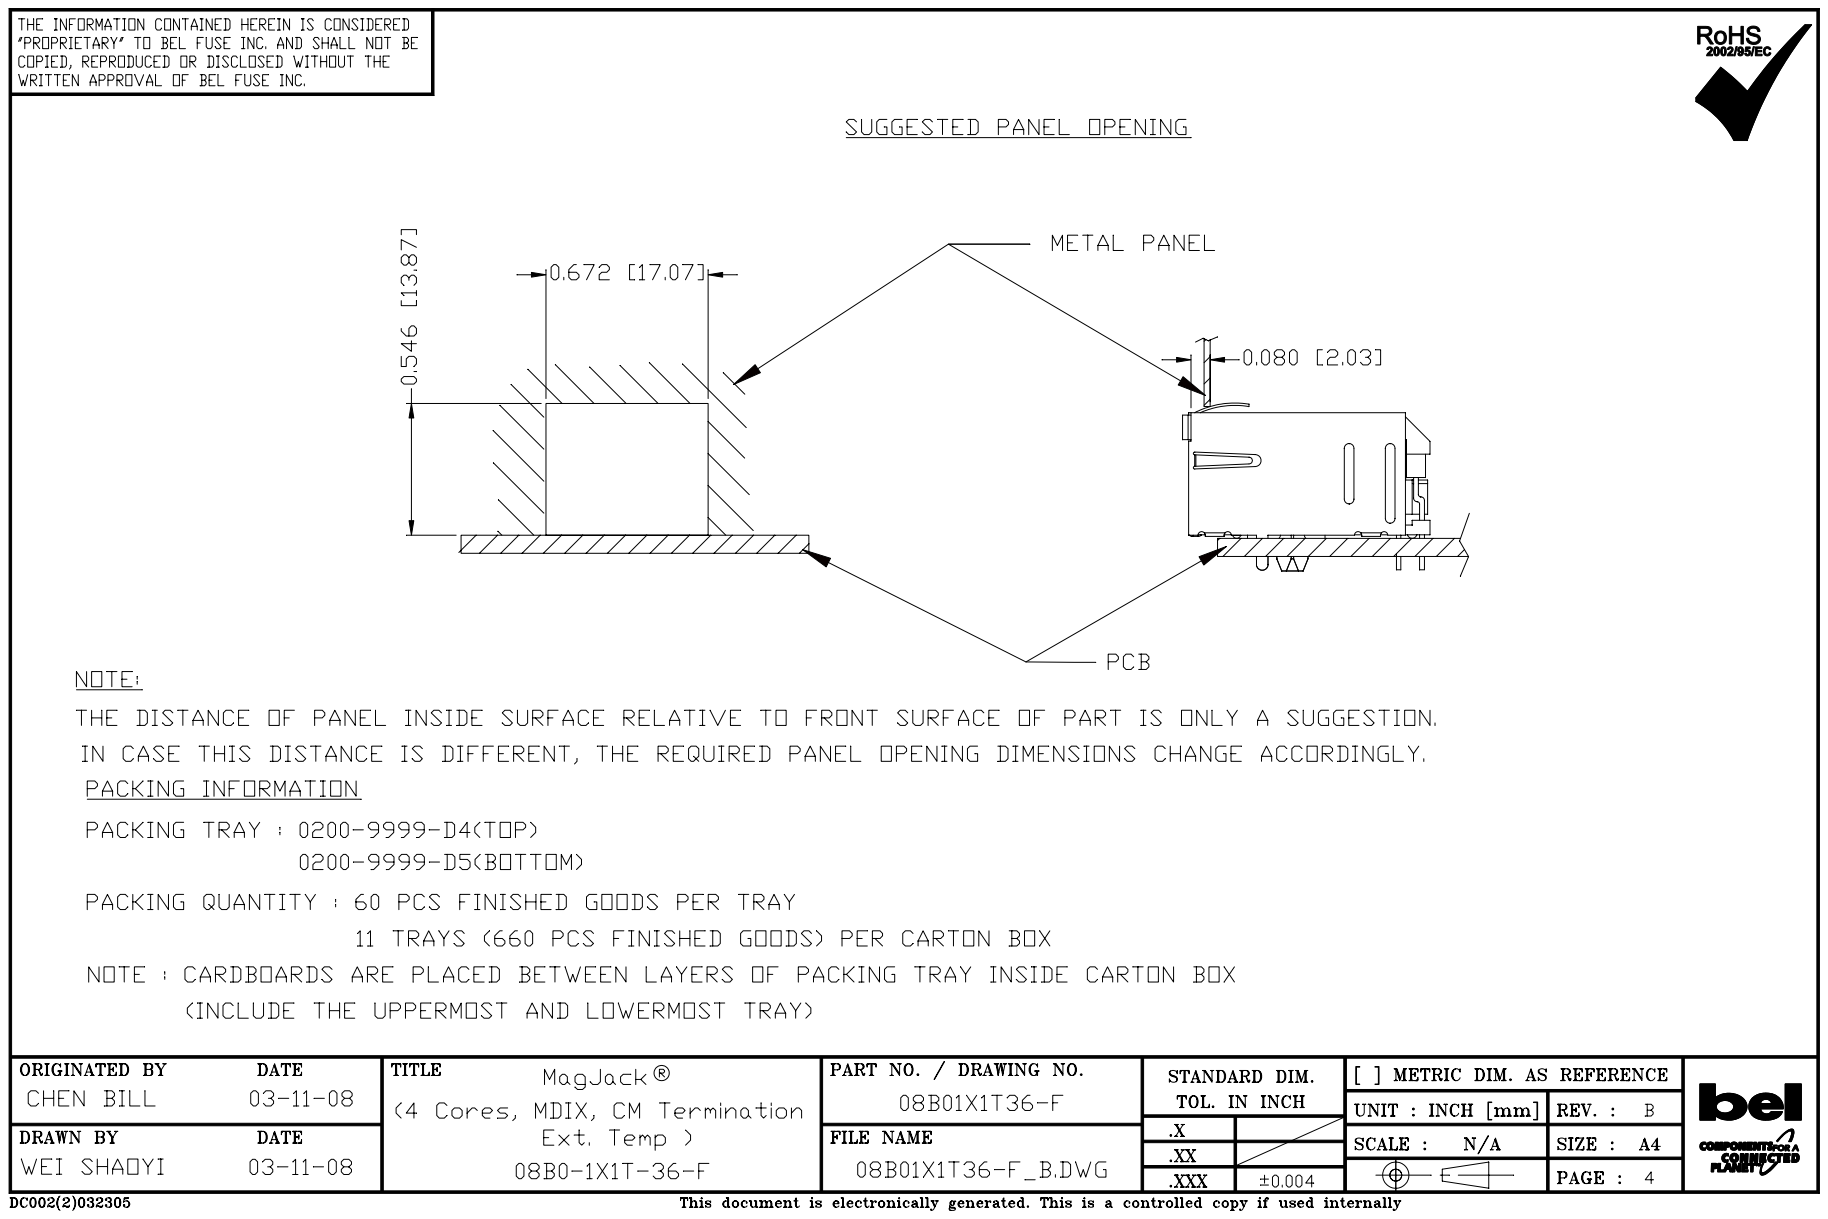
[picture p56: page 3]
