vezril/EtherCoffee/(list of files, drawings)

Other design files:
pcb/Ethernet Controller - CS8900A.ms10
pcb/PSU/PSU.ms10
pcb/Switch/Switch.ms10
